Zeren/ESP32-power-controller/Manufacturing/Tasmota-power-controller.xlsx

Comment | Description | Designator | Footprint | LibRef | Manufacturer Part Number | Quantity | Supplier 1 | Supplier Part Number 1 | Supplier 2 | Supplier Part Number 2 | Supplier 3 | Supplier Part Number 3
1u, 25V, X7R | CAP CER 1UF 25V X7R 0603 | C1, C2, C3, C4, C5, C7, C8, C13, C17, C23, C26 | SMD0603 | CGA3E1X7R1E105K080AC | CGA3E1X7R1E105K080AC | 11 | Mouser | 810-CGA3E1X7R1E105K | Farnell | 2346962 | Digi-Key | 445-6931-1-ND
47u, 10V, X7R | Cap Ceramic 47uF 10V X7R 20% Pad SMD 1210 125C T/R | C6, C18, C19, C24, C25 | SMD1210 | CL32B476MPJNNNE | CL32B476MPJNNNE | 5 | Mouser | 187-CL32B476MPJNNNE | Arrow Electronics | CL32B476MPJNNNE
1p4±0p1 200V C0G | 0603 200 V 1.4 pF ±0.1% Tolerance C0G Multilayer Ceramic Capacitor | C9, C10 | SMD0603 | 06032U1R4BAT2A | 06032U1R4BAT2A | 2 | Mouser | 581-06032U1R4BAT2A
12p 100V C0G 1% | Cap Ceramic 12pF 100V C0G 1% SMD 0603 125°C T/R | C11, C12 | SMD0603 | 06031U120FAT2A | 06031U120FAT2A | 2 | Mouser | 581-06031U120FAT2A
10u, 50V, X5R | CAP CER 10UF 50V X5R 1206 | C14, C20, C28 | SMD1206 | UMK316BBJ106KL-T | UMK316BBJ106KL-T | 3 | Mouser | 963-UMK316BBJ106KL-T | Digi-Key | 587-5960-1-ND | Avnet | UMK316BBJ106KL-T
33n, 50V, X7R | 0603 33nF Ceramic Multilayer Capacitor; 50 V dc; +125degC; X7R Dielectric; +/-5% | C15, C16, C21, C22, C27, C30 | SMD0603 | 06035C333JAT2A | 06035C333JAT2A | 6 | Mouser | 581-06035C333J | Farnell | 2280893 | Digi-Key | 478-3723-1-ND
100n, 25V, X7R | AVX - 06033C104KAT2A - CAP, MLCC, X7R, 0.1UF, 25V, 0603 | C29 | SMD0603 | 06033C104KAT2A | 06033C104KAT2A | 1 | Farnell | 2530141 | Digi-Key | 478-3714-1-ND
100u, ALU, 35V | WURTH ELEKTRONIK 860010573007 Electrolytic Capacitor, 100 F, 35 V, WCAP-ATG8 Series, 20%, Radial Leaded, 6.3 mm | C31 | WCAP-ATLI_6.3x11x2.5 | 860010573007 | 860010573007 | 1 | Mouser | 710-860010573007 | Digi-Key | 732-8737-1-ND
CDDFN2-T5.0LC | TVS DIODE 5VWM 25VC DFN2 | D1 | CDDFN2-T5.0LC | CDDFN2-T5.0LC | CDDFN2-T5.0LC | 1 | Mouser | 652-CDDFN2-T5.0LC | Farnell | 1860785 | Digi-Key | CDDFN2-T5.0LCCT-ND
PMEG60T30ELRX | 60 V, 3 A low leakage current Trench MEGA Schottky barrier rectifier | D2, D3, D4, D5, D9, D10 | SOD123 | PMEG60T30ELRX | PMEG60T30ELRX | 6 | Mouser | 771-PMEG60T30ELRX | Farnell | 2901049 | Digi-Key | 1727-7806-1-ND
GREEN | MULTICOMP - MCL-S270GC - LED, 0805, GREEN, 10MCD, 570NM | D6, D7, D8, D11, D12, D13, D14 | MCL-S270 | MCL-S270GC | MCL-S270GC | 7 | Farnell | 1581242 | Newark | 14N9356
SMDJ24A | ESD Suppressors / TVS Diodes 5kW 24V 5% Uni-Directional | D15 | DO-214AB | SMDJ24A | 5.0SMDJ24A | 1 | Mouser | 576-5.0SMDJ24A
0458002.DR | FUSE BRD MNT 2A 48VAC 75VDC 1206 | F1 | SMD1206 - FUSE | 0458002.DR | 0458002.DR | 1 | Mouser | 576-0458002.DR | Farnell | 1702533 | Digi-Key | F2931CT-ND
73251-1350 | MOLEX 73251-1350. RF/COAXIAL, SMA JACK, STRAIGHT, 50 OHM, SMD | J1 | 73251-1350 | 73251-1350 | 73251-1350 | 1 | Mouser | 538-73251-1350 | Farnell | 2781996 | Digi-Key | WM9458-ND
691321100006 | WR-TBL Series 3211 - 3.50 mm Vertical PCB Header | J2, J11 | 691321100006 | 691321100006 | 691321100006 | 2 | Mouser | 710-691321100006 | Farnell | 1841313 | Digikey | 732-2767-ND
61300611821 | WR-PHD 2.54 mm Socket Header | J3 | 61300611821 | 61300611821 | 61300611821 | 1 | Mouser | 710-61300611821 | Farnell | 2827893
691216510003S | 3 pin WR-TBL Series 2165S - 5.08 mm Horizontal Entry Modular w. Rising Cage Clamp | J4, J5, J6, J7, J8, J9 | 691216510003S | 691216510003S | 691216510003S | 6 | Mouser | 710-691216510003S | Farnell | 3767921 | Digi-Key | 732-691216510003S-ND
691321100002 | WR-TBL Series 3211 - 3.50 mm Vertical PCB Header | J10 | 691321100002 | 691321100002 | 691321100002 | 1 | Mouser | 710-691321100002 | Farnell | 1841308 | Digikey | 732-2763-ND
G2RL-1-E24VDC | Power/Signal Relay, SPDT, Momentary, 0.17A (Coil), 24VDC (Coil), 400mW (Coil), 16A (Contact), 300VDC (Contact), DC Input, AC/DC Output, Through Hole-Straight Mount | K1, K2, K3, K4, K5, K6 | G2RL | G2RL-1-E24VDC | G2RL-1-E24VDC | 6
0603DC-2N7XJRW | RF Inductor, ceramic core, 5% tol, SMT, RoHS, halogen-free | L1, L2 | SMD0603 - L | 0603DC-2N7XJRW | 0603DC-2N7XJRW | 2 | Mouser | 994-0603DC-2N7XJRW | Farnell | 3639697
22n, 2%, 3.15GHz | Ind Chip Wirewound 22nH 2% 250MHz 44Q-Factor Ceramic 850mA 0603 Punched Paper T/R | L3 | SMD0603 - L | 0603HP-22NXGLW | 0603HP-22NXGLW | 1 | Mouser | 994-0603HP-22NXGLW | Farnell | 2286150
7447798620 |  | L4 | WE-PDF_1064 | CMP-0227-00046-2 |  | 1
BC846 |  | Q1 | SOT363 | BC846 Dual | BC846BS | 1 | Farnell | 2317636
NX3008NBKW | NXP - NX3008NBKW - MOSFET, N CH, 30V, 350MA, SOT323 | Q2, Q3, Q4, Q5, Q6, Q7, Q8 | SOT323 | NX3008NBKW | NX3008NBKW | 7 | Mouser | 771-NX3008NBKW,115 | Farnell | 2069546 | Arrow | NX3008NBKW,115
12k, 1% | RES SMD 12K OHM 1% 1/4W 0603 | R1, R3, R4, R6, R13, R16, R17, R18, R21, R24, R27 | SMD0603 - R | RCS060312K0FKEA | RCS060312K0FKEA | 11 | Mouser | 71-RCS060312K0FKEA | Farnell | 3294375 | Digi-Key | RCS060312K0FKEA-ND
22R, 1% | YAGEO (PHYCOMP) - RC0603FR-0722RL - RES, THICK FILM, 22R, 1%, 0.1W, 0603 | R2, R5, R7, R8, R11, R12, R19, R20 | SMD0603 - R | RC0603FR-0722RL | RC0603FR-0722RL | 8 | Mouser | 603-RC0603FR-0722RL | Farnell | 9238280 | Digi-Key | 311-22.0HRCT-ND
150k, 1% | YAGEO - RC0603FR-07150KL - RES, 150K, 1%, 0.1W, 0603, THICK FILM | R9, R10, R14, R15, R22, R23, R25, R30 | SMD0603 - R | RC0603FR-07150KL | RC0603FR-07150KL | 8 | Mouser | 603-RC0603FR-07150KL | Farnell | 9238743 | Digi-Key | 311-150KHRCT-ND
47k, 1% | RES SMD 47K OHM 1% 1/10W 0603 | R26 | SMD0603 - R | RC0603FR-0747KL | RC0603FR-0747KL | 1 | Mouser | 603-RC0603FR-0747KL | Farnell | 2421877 | Digi-Key | 311-47.0KHRCT-ND
15k, 1% | Res Thick Film 0603 15K Ohm 1% 1/10W ?100ppm/?C Molded SMD Paper T/R | R28 | SMD0603 - R | RC0603FR-0715KL | RC0603FR-0715KL | 1 | Mouser | 603-RC0603FR-0715KL | Farnell | 3495741 | Digi-Key | 311-15.0KHRCT-ND
1k, 1% | MULTICOMP - MCWR06X1001FTL - RES, THICK FILM, 1K, 1%, 0.1W, 0603 | R29, R32 | SMD0603 - R | MCWR06X1001FTL | MCWR06X1001FTL | 2 | Farnell | 2447272 | Newark | 94X1378
1R, 1% | SMD Chip Resistor, 1 Ohm, ± 1%, 100 mW, 0603 [1608 Metric], Thick Film, General Purpose | R31 | SMD0603 - R | RC0603FR-071RL | RC0603FR-071RL | 1 | Mouser | 603-RC0603FR-071RL | Newark | 75X0138 | Digi-Key | 311-1.00HRCT-ND
39k, 1% | RES SMD 39K OHM 1% 1/10W 0603 | R33 | SMD0603 - R | RC0603FR-0739KL | RC0603FR-0739KL | 1 | Mouser | 603-RC0603FR-0739KL | Arrow | RC0603FR-0739KL | Farnell | 9238670
ESP32-S3FN8 | WiFi Modules - 802.11 SMD IC , Dual-Core MCU, Wi-Fi 2.4G BLE 5.0 combo, 8 MB Oc | U1 | QFN40P700X700X90_HS-57N | ESP32-S3FN8 | ESP32-S3FN8 | 1 | Mouser | 356-ESP32-S3FN8 | Digi-Key | 1965-ESP32-S3FN8-ND | TME | ESP32-S3FN8
SHT30-DIS-B2.5KS | Humidity/Temperature Sensor Digital Serial (I2C) Automotive 8-Pin TDFN EP T/R | U2 | DFN08 - 2.5X2.5MM | SHT30-DIS-B2.5KS | SHT30-DIS-B2.5KS | 1 | Mouser | 403-SHT30-DIS-B | Arrow Electronics | SHT30-DIS-B2.5KS | Digi-Key | 1649-1009-1-ND
SIC479ED-T1-GE3 | Switching Voltage Regulators microBUCK 4.5-55V; 3A | U3 | POWERPAK_MLP55-27L_VIS | SIC479ED-T1-GE3 | SIC479ED-T1-GE3 | 1 | Mouser | 78-SIC479ED-T1-GE3 | Digi-Key | 742-SIC479ED-T1-GE3CT-ND | Newark | 23AH3586
830108208709 | Parallel - Fundamental Quartz Crystal, 40MHz Nom | X1 | CFPX-218 | 830108208709 | 830108208709 | 1 | Mouser | 710-830108208709 | Digikey | 1923-830108208709CT-ND | Rs | 197500
