Zeren/ESP32-power-controller/(list of files, drawings)

Other design files:
Altium/ESP32-power-controller/ESP32-power-controller.PrjPcb
Altium/ESP32-power-controller/MCU.SchDoc
Altium/ESP32-power-controller/Power_input.SchDoc
Altium/ESP32-power-controller/Relays.SchDoc
Altium/ESP32-power-controller/SMPS_3V3.SchDoc
