Zeren/ESP32-power-controller/(commit log)

2025-12-23 Add PCB and manufacturing data for rev. 0
    [ESP32-power-controller.PrjPcb, MCU.SchDoc, Power_input.SchDoc, Relays.SchDoc, SMPS_3V3.SchDoc]
2025-12-23 Add manufacturing data for rev 0
    [Tasmota-power-controller-PP.xlsx, Tasmota-power-controller.xlsx]
2025-12-23 Changes for rev. 1
    [ESP32-power-controller.PrjPcb, MCU.SchDoc, SMPS_3V3.SchDoc]
2026-01-18 Changes for rev. 1 Changes in ESP32 gpio connections !!! warning: gpio 34, 35, 36 and 39 are input only pins. These pins do NOT have internal pull-up or pull-down resistors.
    [MCU.SchDoc, Relays.SchDoc]
